itswinti/uvcMeter/docs/etc/uvcMeter_Schematic_v1.png

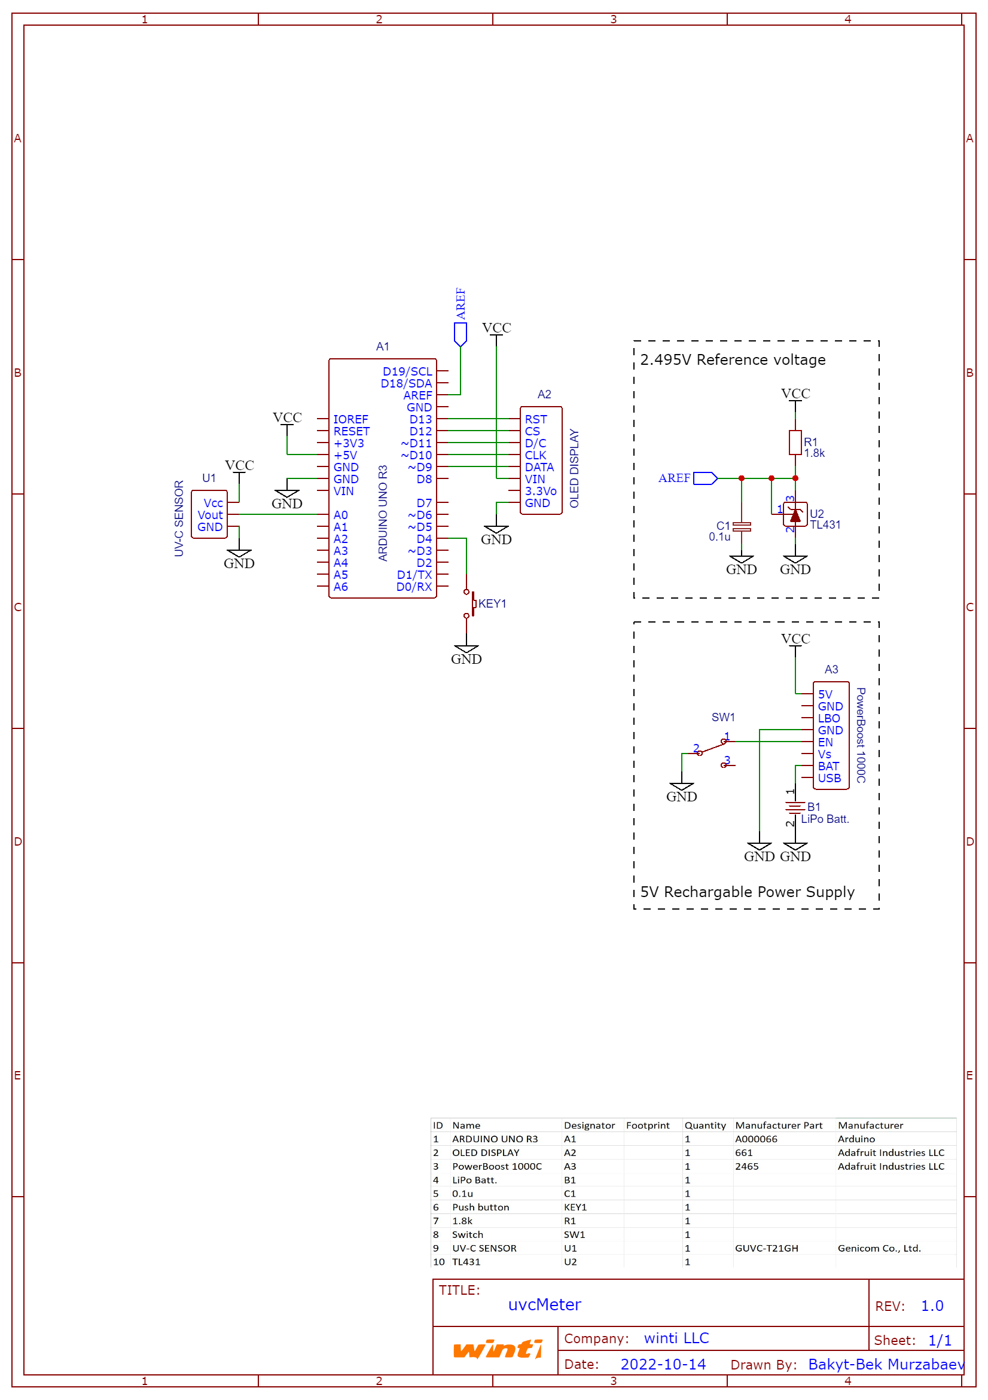
docs/etc/uvcMeter_Schematic_v1.png
