itswinti/uvcMeter/docs/etc/uvcMeter_BOM.xlsx

ID | Name | Designator | Footprint | Quantity | Manufacturer Part | Manufacturer | Supplier | Supplier Part | Harware configuration
 |  |  |  |  |  |  |  |  | #1 | #2 | #3
1 | ARDUINO UNO R3 | A1 |  | 1 | A000066 | Arduino | Digi-Key | 1050-1024-ND | X | X | X
2 | OLED DISPLAY | A2 |  | 1 | 661 | Adafruit Industries LLC | Digi-Key | 661-ND |  |  | X
3 | PowerBoost 1000C | A3 |  | 1 | 2465 | Adafruit Industries LLC |  |  |  |  | X
4 | LiPo Batt. | B1 |  | 1 |  |  |  |  |  |  | X
5 | 0.1u | C1 |  | 1 |  |  |  |  |  | X | X
6 | Push button | KEY1 |  | 1 |  |  |  |  | X | X | X
7 | 1.8k | R1 |  | 1 |  |  |  |  |  | X | X
8 | Switch | SW1 |  | 1 |  |  |  |  |  |  | X
9 | UV-C SENSOR | U1 |  | 1 | GUVC-T21GH | Genicom Co., Ltd. | Digi-Key | 2096-GUVC-T21GH-ND | X | X | X
10 | TL431 | U2 |  | 1 |  |  |  |  |  | X | X
