itswinti/uvcMeter/docs/etc/uvcMeter_Schematic_v1.pdf

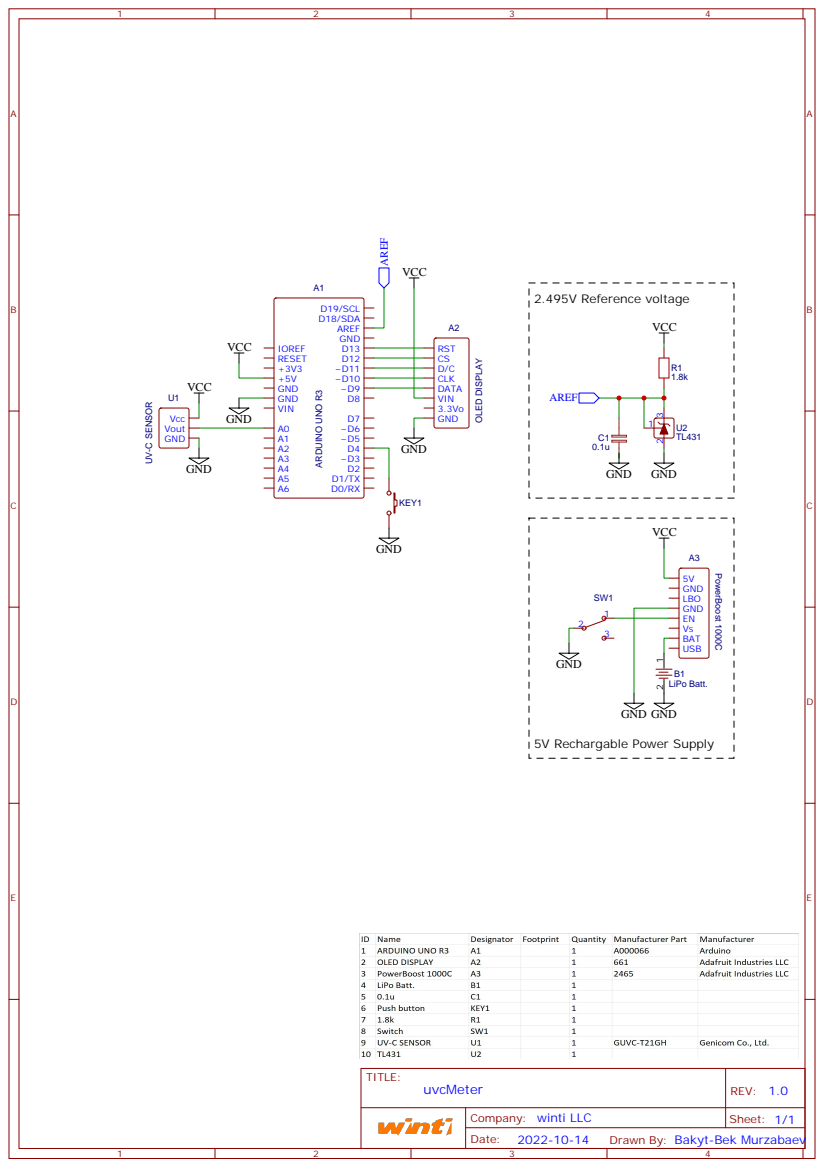
[picture p6: page 1]

Drawn By: Bakyt-Bek Murzabaev
