itswinti/uvcMeter/src/oled.h

#ifndef OLED_H
#define OLED_H

void initDisplay(void);             // Function to initialize the OLED Display
void refreshDisplayMetering(void);  // Displays UVC energy/intensity info
void refreshDisplaySetting(void);   // Displays UVC wavelength setting

//****************************************************************************//
#endif /* OLED_H */
//****************************************************************************//
