itswinti/uvcMeter/src/sprint.h

#ifndef SPRINT_H
#define SPRINT_H

void initDisplay(void);             // Function to initialize the Serial.print 
void refreshDisplayMetering(void);  // Prints calculated energy/intensity info
void refreshDisplaySetting(void);   // Prints updated UVC wavelength

//****************************************************************************//
#endif /* SPRINT_H */
//****************************************************************************//
