itswinti/uvcMeter/(commit log)

2022-10-18 Update README.md
    URLs inserted
2022-10-18 Update README.md Support for Arduino Pro Mini added
